Aditya-Bodhi/automated_chemical_mixer/pinout/esp32_pinout.jpg

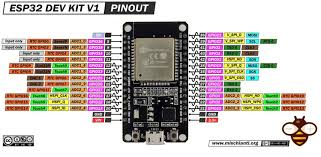
pinout/esp32_pinout.jpg
