Aditya-Bodhi/automated_chemical_mixer/DIAGRAM.jpg

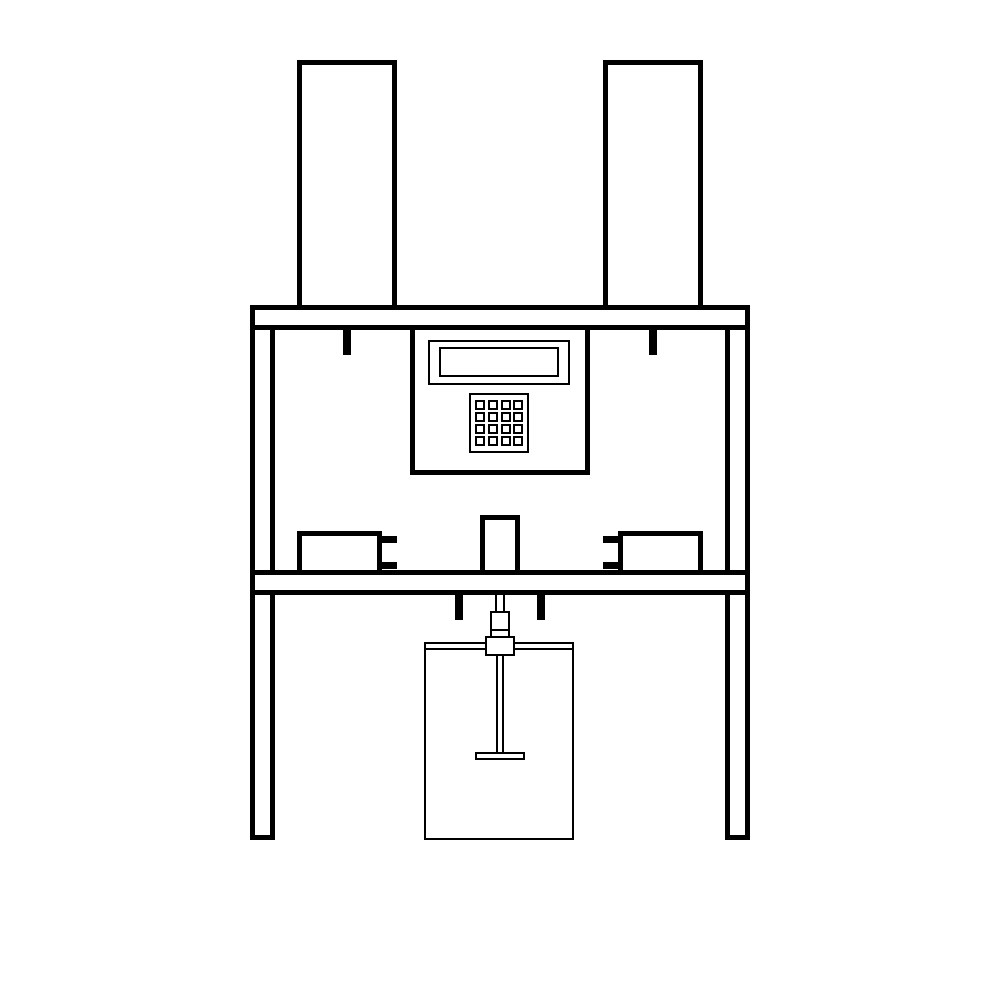
DIAGRAM.jpg
