Aditya-Bodhi/automated_chemical_mixer/pinout/i2c_pinout.webp

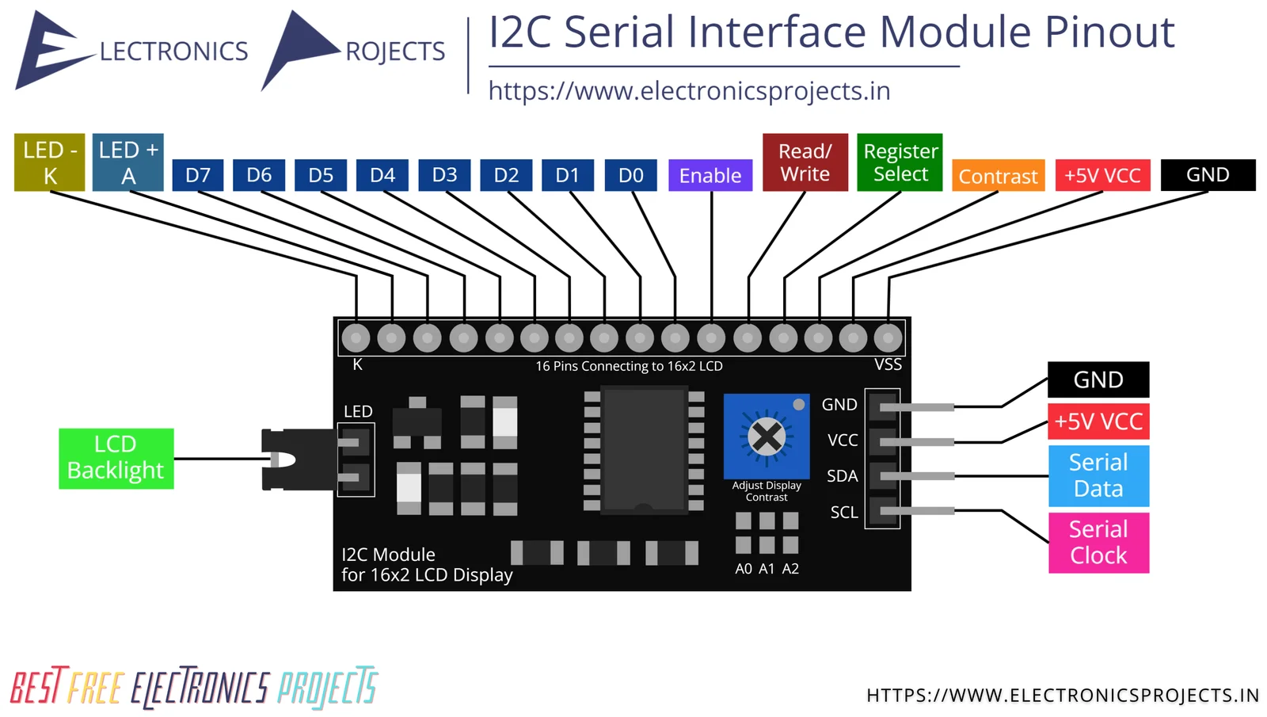
pinout/i2c_pinout.webp
