Aditya-Bodhi/automated_chemical_mixer/spreadsheets/Project-II component list.xlsx

Component | Quantity | Price | Order date | Delivery date | Status | ROD | RDD
ESP32 Devkit V1 | 1 | 350 | 2025-02-08 | 2025-02-08 | Received
12V R385 Pump | 2 | 298 | 2025-02-06 | 2025-02-08 | Received
YF-S401 Flow sensor | 2 | 382 | 2025-02-06 | 2025-02-08 | Received
5V Two channel relay module | 1 | 75 | 2025-02-06 | 2025-02-10 | Received
L298N Motor driver | 1 | 180 | 2025-02-08 | 2025-02-08 | Received
100RPM 12V DC Motoor | 1 | 120 | 2025-02-08 | 2025-02-08 | Received
SG90 Servo motor | 1 | 120 | 2025-02-08 | 2025-02-08 | Received
16*2 LCD screen | 1 | 89 | 2025-02-06 | 2025-02-08 | Received
4*4 Matrix keypad | 2 | 145+153 | 2025-02-06 | 2025-02-10 | Received | 2025-02-25
Jumper wires (mtm) | 1 | 101 | 2025-02-06 | 2025-02-10 | Received
Jumper wires (ftm) | 1 | 97 | 2025-02-06 | 2025-02-10 | Received
5V Buzzer | 1 | 10 | 2025-02-08 | 2025-02-08 | Received
10K Potentiometer | 2 | 20 | 2025-02-08 | 2025-02-08 | Received
12V 1A DC adapter | 1 | 110 | 2025-02-08 | 2025-02-08 | Received
DC Adapter jjack | 1 | 15 | 2025-02-08 | 2025-02-08 | Received
Header pin (m) | 2 | 10 | 2025-02-08 | 2025-02-08 | Received
Header pin (f) | 2 | 10 | 2025-02-08 | 2025-02-08 | Received
I2C Moudle for LCD | 1 | 46 | 2025-02-19 | 2025-02-20 | Received
I2C Moudle for Keypad | 1 | 83 | 2025-02-25
