Aditya-Bodhi/automated_chemical_mixer/testing/esp32_testing/lcd_keypad_test_esp32/connections.txt.txt

Wiring (ESP32 to LCD & Keypad)
LCD to I2C

VCC → 3.3V or 5V
GND → GND
SDA → GPIO 21
SCL → GPIO 22
Keypad Connections (Modify GPIOs as needed)

Rows: GPIO 13, 12, 14, 27
Columns: GPIO 26, 25, 33, 32
