Aditya-Bodhi/automated_chemical_mixer/testing/esp32_testing/flow_sensor_test_esp32/connections.txt

Red → VCC (3.3V or 5V on ESP32)
Black → GND
Yellow (Signal) → GPIO 13 (or any other digital pin)
