Aditya-Bodhi/automated_chemical_mixer/testing/esp32_testing/lcd_i2c_test_esp32/connections.txt

3.3V or 5V	VCC
GND	GND
GPIO 21	SDA
GPIO 22	SCL
