Aditya-Bodhi/automated_chemical_mixer/testing/esp32_testing/relay_test_esp32/connections.txt

VCC - 3V
GND - GND
IN1 - GPIO 26
IN2 - GPIO 27
