Aditya-Bodhi/automated_chemical_mixer/testing/esp32_testing/buzzer_test_esp32/connections.txt

Connections
+ve => GPIO 26
-ve => GPIO 32
