Aditya-Bodhi/automated_chemical_mixer/testing/esp32_testing/keypad_test_esp32/connections.txt

Row 1 (R1) → GPIO 13  
Row 2 (R2) → GPIO 12  
Row 3 (R3) → GPIO 14  
Row 4 (R4) → GPIO 27  
Column 1 (C1) → GPIO 26  
Column 2 (C2) → GPIO 25  
Column 3 (C3) → GPIO 33  
Column 4 (C4) → GPIO 32
