Aditya-Bodhi/automated_chemical_mixer/(list of files, drawings)

Other design files:
Chemical mixer pcb.eprj
