Aditya-Bodhi/automated_chemical_mixer/(commit log)

2025-03-02 Create Project-II component list.xlsx
    [Project-II component list.xlsx]
2025-03-25 Create pump run duration.txt
2025-03-26 Update pump run duration.txt
2025-05-03 Create track connections.txt
